trevor-makes/avr-z80-part1/(threads)

Thread 1 (2025-10-03):

Error when compiling with Arduino Ide

carlostmgps, 2025-10-03:
Arduino: 1.8.19 (Linux), Board: "Arduino Nano, ATmega328P"

WARNING: Category '' in library core is not valid. Setting to 'Uncategorized'
/home/carloscheung/Downloads/z80/avr-z80-part1/avr-z80-part1.ino: In instantiation of ‘static void Z80Clock::wait_ticks() [with unsigned char N = 0]’:
/home/carloscheung/Downloads/z80/avr-z80-part1/avr-z80-part1.ino:88:24:   recursively required from ‘static void Z80Clock::wait_ticks() [with unsigned char N = 2]’
   88 |       wait_ticks<N - 1>();
      |       ~~~~~~~~~~~~~~~~~^~
/home/carloscheung/Downloads/z80/avr-z80-part1/avr-z80-part1.ino:88:24:   required from ‘static void Z80Clock::wait_ticks() [with unsigned char N = 3]’
/home/carloscheung/Downloads/z80/avr-z80-part1/avr-z80-part1.ino:173:26:   required from here
  173 |   Z80Clock::wait_ticks<3>();
      |   ~~~~~~~~~~~~~~~~~~~~~~~^~
avr-z80-part1:88:24: error: no matching function for call to ‘Z80Clock::wait_ticks<(0 - 1)>()’
   88 |       wait_ticks<N - 1>();
      |       ~~~~~~~~~~~~~~~~~^~
/home/carloscheung/Downloads/z80/avr-z80-part1/avr-z80-part1.ino:84:15: note: candidate: ‘template<unsigned char N> static void Z80Clock::wait_ticks()’
   84 |   static void wait_ticks() {
      |               ^~~~~~~~~~
/home/carloscheung/Downloads/z80/avr-z80-part1/avr-z80-part1.ino:84:15: note:   template argument deduction/substitution failed:
exit status 1
no matching function for call to ‘Z80Clock::wait_ticks<(0 - 1)>()’

This report would have more information with
"Show verbose output during compilation"
option enabled in File -> Preferences.

i just simply unzip the core.git and put it into the library file
and i found this error,i cant figure out how to fix it.
Welp i know this project's latest update time is over 2 years but i hope the own can still see my message

trevor-makes, 2025-10-03:
This project doesn't use the Arduino IDE, you need to use [VSCode](https://code.visualstudio.com/) with the [PlatformIO](https://platformio.org/) plugin. I uploaded a video outlining how to do so [here](https://www.youtube.com/watch?v=nlE2203Q3XI).

trevor-makes, 2025-10-06:
Looking good! I think I see the problem: I changed the wiring of the Z80 control signals from the original version after someone found an issue with it (in [this](https://www.youtube.com/watch?v=SaIY3llTByk) video) and it looks like your wiring matches the original. Check the schematics in the readme and try making those changes. If you look in the _images_ folder inside the project folder, you should see two sets of images: wiring-arduino.png and wiring-sram-z80.png are the old schematics, and wiring-arduino-2.png and wiring-sram-z80-2.png are the new schematics. I'll take a new picture of the breadboard so it matches the new schematic.

trevor-makes, 2025-10-06:
By the way, since you're using the Arduino IDE, be aware that you need to send commands one line at a time; you can't paste them all at once like with the PlatformIO IDE serial monitor. So if you want to import one of the programs like in the readme, you'd have to send "import" first, then ":090000002100017E23862377769E", then ":00000001FF", and it should reply "OK" after you send the last message.

trevor-makes, 2025-10-06:
The wiring that changed should be the white wires in my picture below, and one of the pull-up resistors moves from the right to left side of the Z80.

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

carlostmgps, 2025-10-06:
Thankyou! I gonna try it as soon as possible. This project is the easiest z80 project I have ever seen. It's so cool and I like the way that it's not just sending strings by serial but really using your keyboard to input the values, making it possible to detect other keys and special characters, feeling like really plugging a z80 computer to my monitor.

After I finished the basic part of this project I think I am going to try add some new functions may be using the currently unused Addr15 or may be I can divide it by adding a 32k eeprom?  I think I am trying to make it something like MSX computers.

I hope my English is atleast,... readable?  🤣 I come from Hong Kong and I'm just a secondary school student and although I can understand the assembly language and machine codes, Im not good at making hardware stuffs. Actually I started to learn about mainly z80 and 8085 after I learnt how Gameboy DMG works.its amazing that the variation of z80 can handle lcd, button inputs, large size gameroms even tiles mapping while having a high adaptability with only a 8 bit processer and 64k address.
