trevor-makes/avr-z80-part1/avr-z80-part1.ino

// Copyright (c) 2023 Trevor Makes

#include <core.h>
#include "core/io.hpp"
#include "core/io/bus.hpp"
#include "core/cli.hpp"
#include "core/mon.hpp"
#include "core/mon/z80.hpp"

using core::io::ActiveLow;
using core::io::ActiveHigh;
using core::io::BitExtend;
using core::io::WordExtend;
using core::io::RightAlign;
using core::io::Latch;
using core::io::PortBus;

// Arduino Nano and Uno
#ifdef __AVR_ATmega328P__

// Create Port* wrappers around AVR ports B, C, D
CORE_PORT(B)
CORE_PORT(C)
CORE_PORT(D)

// Output Enable - D2 |         | x
//     Z80 Clock - D3 |         | x
//        Data 4 - D4 |         | C5 - MSB Latch Enable (active high)
//        Data 5 - D5 |         | C4 - LSB Latch Enable (active high)
//        Data 6 - D6 | Arduino | C3 - Bus Read Enable (active low)
//        Data 7 - D7 |   NANO  | C2 - Bus Write Enable (active low)
//        Data 0 - B0 |         | C1 - Z80 RESET
//        Data 1 - B1 |         | C0 - Z80 BUSREQ
//        Data 2 - B2 |   ___   | x
//        Data 3 - B3 |  |USB|  | x
//             * - B4 |__|___|__| B5 - Z80 HALT
// * unused digital pins

// 8-bit data bus [D7 D6 D5 D4 B3 B2 B1 B0]
using DataPort = BitExtend<PortD::Mask<0xF0>, PortB::Mask<0x0F>>;

// Latch upper and lower bytes of 16-bit address from data port
using MSBLatch = ActiveHigh<PortC::Bit<5>>;
using LSBLatch = ActiveHigh<PortC::Bit<4>>;
using OutputEnable = ActiveLow<PortD::Bit<2>>;
using AddressMSB = Latch<DataPort, MSBLatch, OutputEnable>;
using AddressLSB = Latch<DataPort, LSBLatch, OutputEnable>;
using AddressPort = WordExtend<AddressMSB, AddressLSB>;

// Bus control lines
using ReadEnable = ActiveLow<PortC::Bit<3>>;
using WriteEnable = ActiveLow<PortC::Bit<2>>;

using Z80Reset = ActiveLow<PortC::Bit<1>>;
using Z80BusReq = ActiveLow<PortC::Bit<0>>;
using Z80Halt = ActiveLow<PortB::Bit<5>>;

struct Z80Clock {
  // uIO types for Timer2 registers
  CORE_REG(TCCR2A)
  CORE_REG(TCCR2B)
  CORE_REG(OCR2A)
  CORE_REG(OCR2B)
  CORE_REG(TIFR2)

  // Aliases for Timer2 bitfields
  using RegCOM2B = RightAlign<RegTCCR2A::Mask<0x30>>;
  using RegCS2 = RegTCCR2B::Mask<0x07>;
  using RegWGM2 = BitExtend<RegTCCR2B::Bit<WGM22>, RegTCCR2A::Mask<0x03>>;
  using RegOC2B = PortD::Bit<3>;
  using RegOCF2B = RegTIFR2::Bit<OCF2B>;

  static void config() {
    RegWGM2::write(7); // select fast PWM mode w/ OCR2A top
    RegCOM2B::write(3); // clear OC2B at OCR2A, set OC2B at OCR2B
    RegOC2B::config_output(); // GPIO must be in output mode
    RegOCR2A::write(1); // count that resets timer, the clock period
    RegOCR2B::write(0); // count that toggles OC2B (must be <= OCR2A)
    RegCS2::write(1); // 0 to stop, 1 for no prescaler, 2 for /8, etc
  }

  // Wait for N positive clock edges
  template <uint8_t N = 1>
  static void wait_ticks() {
    if (N > 0) {
      RegOCF2B::set(); // clear compare flag
      while (RegOCF2B::is_clear()) {} // wait for clock edge
      wait_ticks<N - 1>();
    }
  }

  static void start() { RegCS2::write(1); }
  static void stop() { RegCS2::write(0); }
};

#else
#error Need to provide configuration for current platform. See __AVR_ATmega328P__ configuration above.
#endif

struct Bus : PortBus<AddressPort, DataPort, ReadEnable, WriteEnable> {
  // Override read_bus to reconfigure DataPort to latch address before reading
  static DATA_TYPE read_bus(ADDRESS_TYPE addr) {
    // Latch address from data port
    DataPort::config_output();
    AddressPort::write(addr);
    // Begin read sequence
    DataPort::config_input();
    ReadEnable::enable();
    // Need at least one cycle delay for AVR read latency
    // Second delay cycle has been sufficient for SRAM/EEPROM with tOE up to 70ns
    core::util::nop<2>(); // insert two NOP delay cycles
    const DATA_TYPE data = DataPort::read();
    // End read sequence
    ReadEnable::disable();
    return data;
  }

  static uint16_t read16(ADDRESS_TYPE addr) {
    return read_bus(addr) | (read_bus(addr + 1) << 8);
  }

  static void write16(ADDRESS_TYPE addr, uint16_t data) {
    write_bus(addr, data & 0xFF);
    write_bus(addr + 1, data >> 8);
  }
};

using core::serial::StreamEx;
using CLI = core::cli::CLI<>;
using core::cli::Args;

// Create command line interface around Arduino Serial
StreamEx serialEx(Serial);
CLI serialCli(serialEx);

// Define interface for core::mon function templates
struct API : core::mon::Base<API> {
  static StreamEx& get_stream() { return serialEx; }
  static CLI& get_cli() { return serialCli; }
  using BUS = Bus;
};

void setup() {
  // Start with Z80 in BUSREQ state to keep RS and WR floating
  // Previously used the RESET state, but this drives RS and WR high instead
  Z80BusReq::config_output();
  Z80BusReq::enable();

  Z80Reset::config_output();
  Z80Halt::config_input();
  Z80Clock::config();

  // Establish serial connection with computer
  Serial.begin(9600);
  while (!Serial) {}
}

void set_baud(Args args) {
  CORE_EXPECT_UINT(API, uint32_t, baud, args, return)
  // NOTE in PlatformIO terminal, type `ctrl-t b` to enter matching baud rate
  Serial.print(F("Type: ctrl-t b "));
  Serial.println(baud);
  // https://forum.arduino.cc/t/change-baud-rate-at-runtime/368191
  Serial.flush();
  Serial.begin(baud);
  while (Serial.available()) Serial.read();
}

void run_until_halt(Args args) {
  Bus::config_float();
  // Hold RESET low for 3 clock pulses
  Z80Reset::enable();
  Z80Clock::wait_ticks<3>();
  Z80Reset::disable();
  // Release BUSREQ to let program run
  Z80BusReq::disable();
  while (!Z80Halt::is_enabled()) {}
  Z80BusReq::enable();
}

// I/O register memory map
const uint16_t STACK_PTR_ADDR = 0x00D8;
const uint16_t YIELD_REG_ADDR = 0x00DA;
const uint16_t READ_REG_ADDR  = 0x00DB;
const uint16_t CLOCK_REG_ADDR = 0x00DC;
const uint16_t WRITE_PTR_ADDR = 0x00DE;
const uint16_t WRITE_BUF_ADDR = 0x00E0;

const uint8_t YIELD_RESET = 0;
const uint8_t YIELD_FLUSH = 1;
const uint8_t YIELD_BREAK = 2;

uint8_t yield_reg;
uint8_t read_reg;
uint16_t millis_offset;

void display_registers() {
  // Read registers pushed on the Z80 stack
  auto print = [](char c){serialEx.print(c);};
  serialEx.println(F("PC   SP   SZ-H-VNC A  HL   BC   DE   SZ-H-VNC A' HL'  BC'  DE'  IX   IY"));
  uint16_t sp = Bus::read16(STACK_PTR_ADDR);
  core::mon::format_hex16(print, Bus::read16(sp + 2)); print(' '); // PC
  core::mon::format_hex16(print, sp + 4); print(' '); // SP
  core::mon::format_bin8(print, Bus::read_bus(sp)); print(' '); // F
  core::mon::format_hex8(print, Bus::read_bus(sp + 1)); print(' '); // A
  core::mon::format_hex16(print, Bus::read16(sp - 2)); print(' '); // HL
  core::mon::format_hex16(print, Bus::read16(sp - 4)); print(' '); // BC
  core::mon::format_hex16(print, Bus::read16(sp - 6)); print(' '); // DE
  core::mon::format_bin8(print, Bus::read_bus(sp - 8)); print(' '); // F'
  core::mon::format_hex8(print, Bus::read_bus(sp - 7)); print(' '); // A'
  core::mon::format_hex16(print, Bus::read16(sp - 10)); print(' '); // HL'
  core::mon::format_hex16(print, Bus::read16(sp - 12)); print(' '); // BC'
  core::mon::format_hex16(print, Bus::read16(sp - 14)); print(' '); // DE'
  core::mon::format_hex16(print, Bus::read16(sp - 16)); print(' '); // IX
  core::mon::format_hex16(print, Bus::read16(sp - 18)); // IY
  serialEx.println();
}

void bios_loop() {
  for (;;) {
    // Write I/O registers
    Bus::config_write();
    Bus::write_bus(YIELD_REG_ADDR, yield_reg);
    Bus::write16(WRITE_PTR_ADDR, WRITE_BUF_ADDR);
    if (read_reg == 0xFF) {
      Bus::write_bus(READ_REG_ADDR, serialEx.read());
    }
    Bus::write16(CLOCK_REG_ADDR, millis() - millis_offset);
    Bus::flush_write();

    // Run Z80 and wait for HALT
    run_until_halt({});

    // Read I/O registers
    Bus::config_read();
    yield_reg = Bus::read_bus(YIELD_REG_ADDR);
    read_reg = Bus::read_bus(READ_REG_ADDR);
    uint16_t write_ptr = Bus::read16(WRITE_PTR_ADDR);

    // Flush output buffer
    for (uint16_t ptr = WRITE_BUF_ADDR; ptr < write_ptr; ++ptr) {
      uint8_t c = Bus::read_bus(ptr);
      if (c == '\n') serialEx.write('\r'); // LF -> CRLF
      serialEx.write(c);
    }

    // Exit when yield parameter is exit or break
    if (yield_reg == YIELD_RESET) {
      return;
    } else if (yield_reg == YIELD_BREAK) {
      millis_offset -= millis();
      display_registers();
      serialCli.prefix("resume");
      return;
    }
  }
}

void run_bios(Args args) {
  yield_reg = YIELD_RESET;
  read_reg = 0xFF;
  millis_offset = 0;
  bios_loop();
}

void resume_bios(Args args) {
  if (yield_reg != YIELD_BREAK) {
    serialEx.println(F("can only resume from break"));
    return;
  }
  millis_offset += millis();
  bios_loop();
}

void loop() {
  static const core::cli::Command commands[] = {
    { F("baud"), set_baud },
    // Assembler commands
    { F("asm"), core::mon::z80::cmd_asm<API> },
    { F("dasm"), core::mon::z80::cmd_dasm<API> },
    { F("label"), core::mon::cmd_label<API> },
    // Execute commands
    { F("run"), run_until_halt },
    { F("bios"), run_bios },
    { F("resume"), resume_bios },
    // Memory monitor commands
    { F("hex"), core::mon::cmd_hex<API> },
    { F("set"), core::mon::cmd_set<API> },
    { F("fill"), core::mon::cmd_fill<API> },
    { F("move"), core::mon::cmd_move<API> },
    // Memory transfer commands
    { F("export"), core::mon::cmd_export<API> },
    { F("import"), core::mon::cmd_import<API> },
    { F("verify"), core::mon::cmd_verify<API> },
  };

  serialCli.prompt(commands);
}
