trevor-makes/avr-z80-part1/(commit log)

2023-03-29 Use BUSREQ to hold Z80 bus instead of RESET
    [main.cpp]
2023-03-29 Change clock generator from CTC to fast PWM
2023-06-03 Make project work with Arduino IDE
2023-06-10 Add example printing random BCD digits
2023-06-11 Interleave read and print to reduce code size
2023-06-12 Move millis and getchar out of reset vectors
